antonloof/bike_ometer/kicad/kicad.kicad_pcb

## KiCad design kicad/kicad.kicad_pcb (2022-01-11)

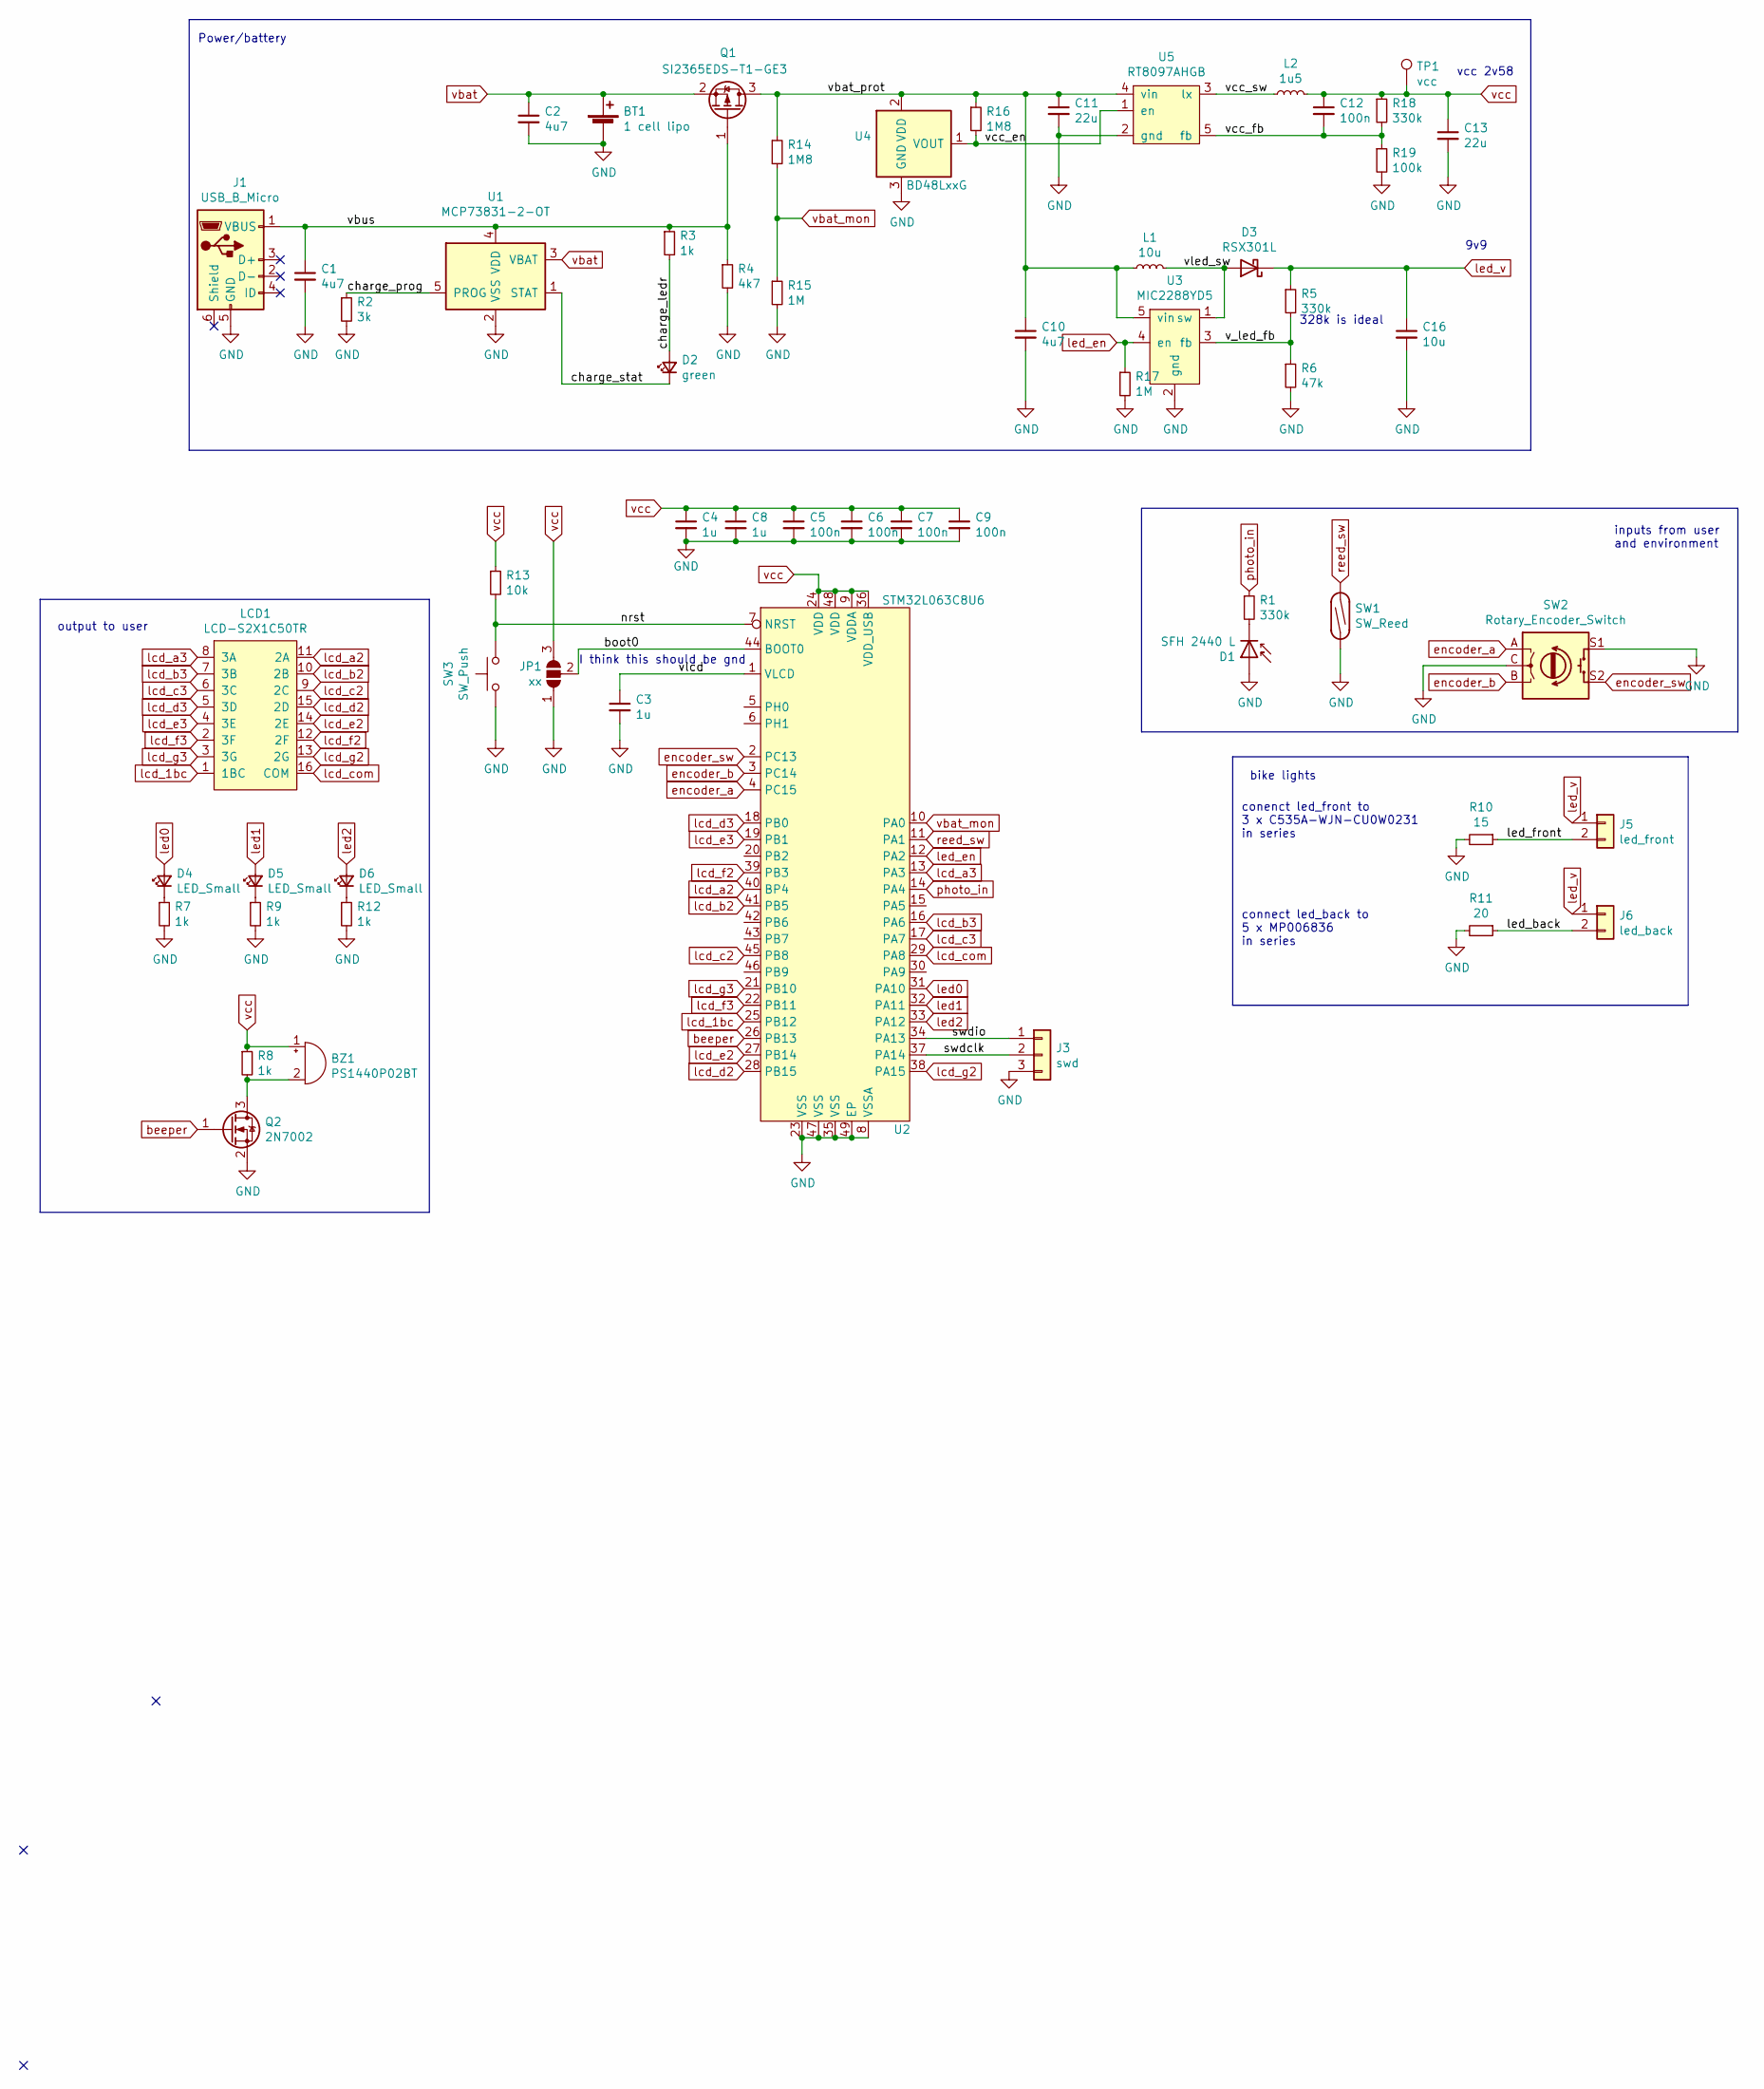
[picture p1: schematic kicad.kicad_sch]

Parts:
BT1: 1 cell lipo; PinHeader_1x02_P2.54mm_Vertical
BZ1: PS1440P02BT; buzzer_d14_p5
C1, C2, C10: 4u7; C_0603_1608Metric_Pad1.05x0.95mm_HandSolder
C3, C4, C8: 1u; C_0603_1608Metric_Pad1.05x0.95mm_HandSolder
C5, C6, C7, C9, C12: 100n; C_0603_1608Metric_Pad1.05x0.95mm_HandSolder
C11, C13: 22u; C_0603_1608Metric_Pad1.05x0.95mm_HandSolder
C16: 10u; C_0603_1608Metric_Pad1.05x0.95mm_HandSolder
D1: SFH 2440 L; sfh-2440-l
D2: green; LED_0603_1608Metric_Pad1.05x0.95mm_HandSolder
D3: RSX301L; SOD-106
D4, D5, D6: LED_Small; LED_0603_1608Metric_Pad1.05x0.95mm_HandSolder
J1: USB_B_Micro; USB_MICRO_10118193-0001LF
J3: swd; PinHeader_1x03_P2.54mm_Vertical
J5: led_front; PhoenixContact_MSTBVA_2,5_2-G_1x02_P5.00mm_Vertical
J6: led_back; PhoenixContact_MSTBVA_2,5_2-G_1x02_P5.00mm_Vertical
JP1: xx; SolderJumper-3_P1.3mm_Open_Pad1.0x1.5mm
L1: 10u; L_Wuerth_WE-PD-Typ-LS
L2: 1u5; L_Sunlord_MWSA0518_5.4x5.2mm
LCD1: LCD-S2X1C50TR
Q1: SI2365EDS-T1-GE3; SOT-23_Handsoldering
Q2: 2N7002; SOT-23
R1, R5, R18: 330k; R_0603_1608Metric_Pad1.05x0.95mm_HandSolder
R2: 3k; R_0603_1608Metric_Pad1.05x0.95mm_HandSolder
R3, R7, R8, R9, R12: 1k; R_0603_1608Metric_Pad1.05x0.95mm_HandSolder
R4: 4k7; R_0603_1608Metric_Pad1.05x0.95mm_HandSolder
R6: 47k; R_0603_1608Metric_Pad1.05x0.95mm_HandSolder
R10: 15; R_0603_1608Metric_Pad1.05x0.95mm_HandSolder
R11: 20; R_0603_1608Metric_Pad1.05x0.95mm_HandSolder
R13: 10k; R_0603_1608Metric_Pad1.05x0.95mm_HandSolder
R14, R16: 1M8; R_0603_1608Metric_Pad1.05x0.95mm_HandSolder
R15, R17: 1M; R_0603_1608Metric_Pad1.05x0.95mm_HandSolder
R19: 100k; R_0603_1608Metric_Pad1.05x0.95mm_HandSolder
SW1: SW_Reed; PhoenixContact_MSTBVA_2,5_2-G_1x02_P5.00mm_Vertical
SW2: Rotary_Encoder_Switch; RotaryEncoder_Alps_EC11E_Vertical_H20mm
SW3: SW_Push; push_sw_purple
TP1: vcc; TestPoint_Pad_1.5x1.5mm
U1: MCP73831-2-OT; SOT-23-5
U2: STM32L063C8U6; QFN-48-1EP_7x7mm_P0.5mm_EP5.6x5.6mm
U3: MIC2288YD5; SOT-23-5_HandSoldering
U4: BD48LxxG; SOT-23
U5: RT8097AHGB; SOT-23-5_HandSoldering

Connections:
/boot0: JP1.2 (C), U2.44 (BOOT0)
/charge_ledr: D2.2 (A), R3.2
/charge_prog: R2.1, U1.5 (PROG)
/charge_stat: D2.1 (K), U1.1 (STAT)
/led_back: J6.2, R11.1
/led_front: J5.2, R10.1
/nrst: R13.2, SW3.2, U2.7 (NRST)
/swdclk: J3.2, U2.37 (PA14)
/swdio: J3.1, U2.34 (PA13)
/v_led_fb: R5.2, R6.1, U3.3 (fb)
/vbat_prot: C10.1, C11.1, L1.1, Q1.3 (D), R14.1, R16.1, U3.5 (vin), U4.2 (VDD), U5.4 (vin)
/vbus: C1.1, J1.1 (VBUS), Q1.1 (G), R3.1, R4.1, U1.4 (VDD)
/vcc_en: R16.2, U4.1 (VOUT), U5.1 (en)
/vcc_fb: C12.2, R18.2, R19.1, U5.5 (fb)
/vcc_sw: L2.1, U5.3 (lx)
/vlcd: C3.1, U2.1 (VLCD)
/vled_sw: D3.2 (A), L1.2, U3.1 (sw)
GND: BT1.2 (-), C1.2, C2.2, C3.2, C4.2, C5.2, C6.2, C7.2, C8.2, C9.2, C10.2, C11.2, C13.2, C16.2, D1.2 (A), J1.5 (GND), J3.3, JP1.1 (A), Q2.2 (S), R2.2, R4.2, R6.2, R7.2, R9.2, R10.2, R11.2, R12.2, R15.2, R17.2, R19.2, SW1.2, SW2.C, SW2.S1, SW3.1, U1.2 (VSS), U2.8 (VSSA), U2.23 (VSS), U2.35 (VSS), U2.47 (VSS), U2.49 (EP), U3.2 (gnd), U4.3 (GND), U5.2 (gnd)
unnamed: BZ1.2 (+), Q2.3 (D), R8.2
unnamed: D1.1 (K), R1.2
unnamed: D4.1 (K), R7.1
unnamed: D5.1 (K), R9.1
unnamed: D6.1 (K), R12.1
beeper: Q2.1 (G), U2.26 (PB13)
encoder_a: SW2.A, U2.4 (PC15)
encoder_b: SW2.B, U2.3 (PC14)
encoder_sw: SW2.S2, U2.2 (PC13)
lcd_1bc: LCD1.1 (1BC), U2.25 (PB12)
lcd_a2: LCD1.11 (2A), U2.40 (BP4)
lcd_a3: LCD1.8 (3A), U2.13 (PA3)
lcd_b2: LCD1.10 (2B), U2.41 (PB5)
lcd_b3: LCD1.7 (3B), U2.16 (PA6)
lcd_c2: LCD1.9 (2C), U2.45 (PB8)
lcd_c3: LCD1.6 (3C), U2.17 (PA7)
lcd_com: LCD1.16 (COM), U2.29 (PA8)
lcd_d2: LCD1.15 (2D), U2.28 (PB15)
lcd_d3: LCD1.5 (3D), U2.18 (PB0)
lcd_e2: LCD1.14 (2E), U2.27 (PB14)
lcd_e3: LCD1.4 (3E), U2.19 (PB1)
lcd_f2: LCD1.12 (2F), U2.39 (PB3)
lcd_f3: LCD1.2 (3F), U2.22 (PB11)
lcd_g2: LCD1.13 (2G), U2.38 (PA15)
lcd_g3: LCD1.3 (3G), U2.21 (PB10)
led0: D4.2 (A), U2.31 (PA10)
led1: D5.2 (A), U2.32 (PA11)
led2: D6.2 (A), U2.33 (PA12)
led_en: R17.1, U2.12 (PA2), U3.4 (en)
led_v: C16.1, D3.1 (K), J5.1, J6.1, R5.1
photo_in: R1.1, U2.14 (PA4)
reed_sw: SW1.1, U2.11 (PA1)
vbat: BT1.1 (+), C2.1, Q1.2 (S), U1.3 (VBAT)
vbat_mon: R14.2, R15.1, U2.10 (PA0)
vcc: BZ1.1 (-), C4.1, C5.1, C6.1, C7.1, C8.1, C9.1, C12.1, C13.1, JP1.3 (B), L2.2, R8.1, R13.1, R18.1, TP1.1, U2.9 (VDDA), U2.24 (VDD), U2.36 (VDD_USB), U2.48 (VDD)

Notes on the sheet:
328k is ideal
I think this should be gnd
connect led_back to 5 x MP006836 in series
bike lights
9v9
vcc 2v58
Power/battery
output to user
inputs from user and environment
conenct led_front to 3 x C535A-WJN-CU0W0231 in series

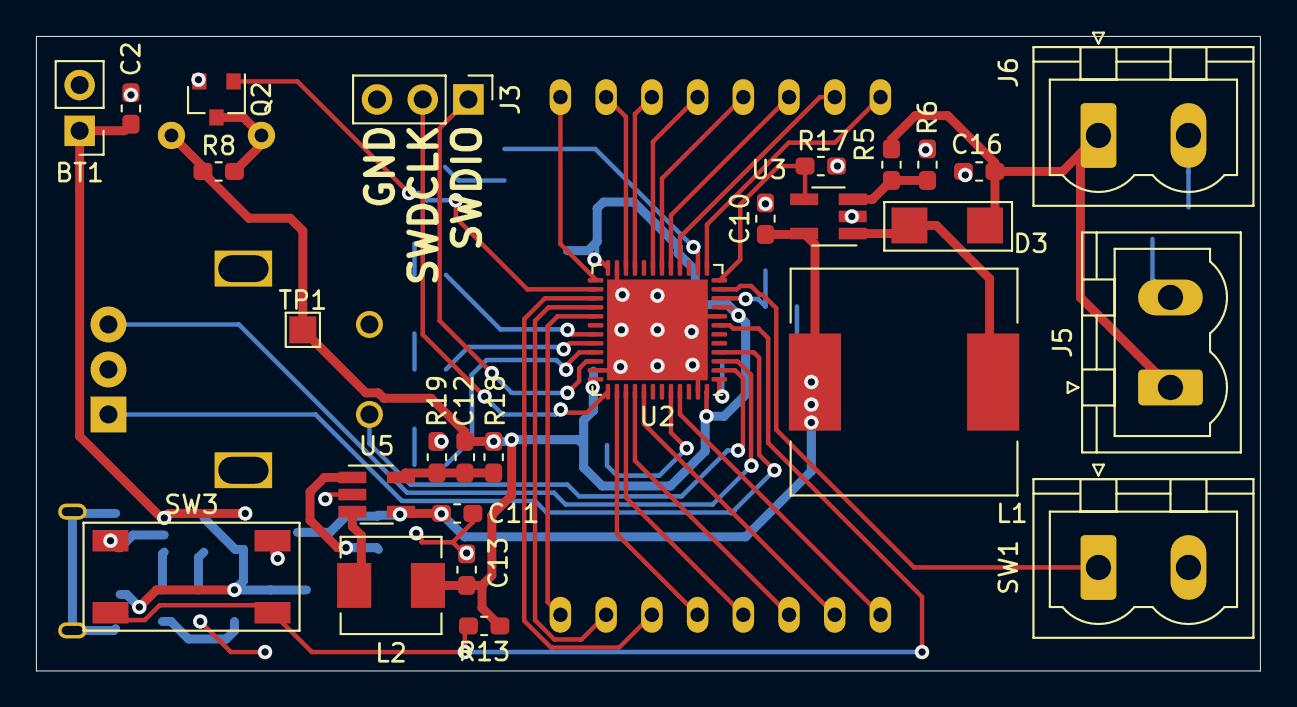
[picture p2: board kicad.kicad_pcb from above]

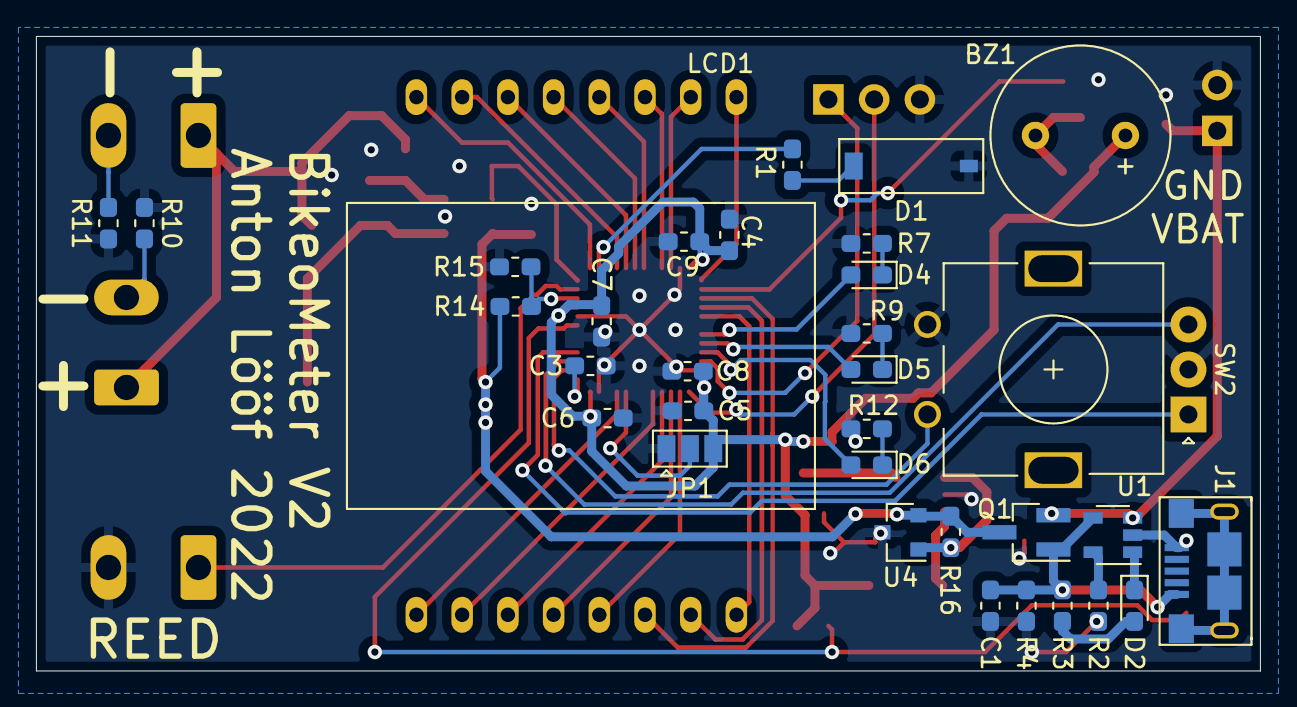
[picture p3: board kicad.kicad_pcb from below]

Board: 2 copper layers, 68.0 x 35.2 mm, 60 parts (33 on the bottom side), 53 nets.
