antonloof/bike_ometer/L063C8U/L063C8U.ioc

Mcu.UserName=STM32L063C8Ux
PA0.GPIO_Label=BAT_MON
PA0.Signal=ADC_IN0
PA1.GPIO_Label=TIM2_REED_SW
PA1.Signal=S_TIM2_CH2
PA10.GPIO_Label=LED0
PA10.Signal=GPIO_Output
PA11.GPIO_Label=LED1
PA11.Signal=GPIO_Output
PA12.GPIO_Label=LED2
PA12.Signal=GPIO_Output
PA13.Signal=SYS_SWDIO
PA14.Signal=SYS_SWCLK
PA15.Signal=LCD_SEG17
PA2.GPIO_Label=LEN_EN
PA2.Signal=GPIO_Output
PA3.Signal=LCD_SEG2
PA4.GPIO_Label=PHOTO_IN
PA4.Signal=ADC_IN4
PA6.Signal=LCD_SEG3
PA7.Signal=LCD_SEG4
PA8.Signal=LCD_COM0
PB0.Signal=LCD_SEG5
PB1.Signal=LCD_SEG6
PB10.Signal=LCD_SEG10
PB11.Signal=LCD_SEG11
PB12.Signal=LCD_SEG12
PB13.GPIO_Label=BEEPER
PB13.Signal=GPIO_Output
PB14.Signal=LCD_SEG14
PB15.Signal=LCD_SEG15
PB3.Signal=LCD_SEG7
PB4.Signal=LCD_SEG8
PB5.Signal=LCD_SEG9
PB8.Signal=LCD_SEG16
PC13.GPIO_Label=INT_ENCODER_SW
PC13.Signal=GPXTI13
PC14-OSC32_IN.GPIO_Label=INT_ENCODER_B
PC14-OSC32_IN.Signal=GPXTI14
PC15-OSC32_OUT.GPIO_Label=ENCODER_A
PC15-OSC32_OUT.Signal=GPIO_Input
