antonloof/bike_ometer/(commit log)

2021-06-16 Add schema and basic SW tests
    [kicad.kicad_pcb, kicad.sch]
2021-07-03 Use a mcu in stock ...
    [kicad.sch]
2021-10-19 version updates
    [kicad.sch]
2021-10-19 Some schema work with correct mcu
    also rm some shit
    [kicad.sch]
2021-10-21 Place n route
    [kicad.kicad_pcb, kicad.sch]
2021-10-24 rev1 pcb done
    [kicad.kicad_pcb]
2022-01-11 Rev2 psb with correct mcu size...
    [kicad.kicad_pcb, kicad.kicad_sch]
